Leimer-G/GamePad_BLE_Esp32/Schematic_GamePad_BLE.pdf

## SSD1306

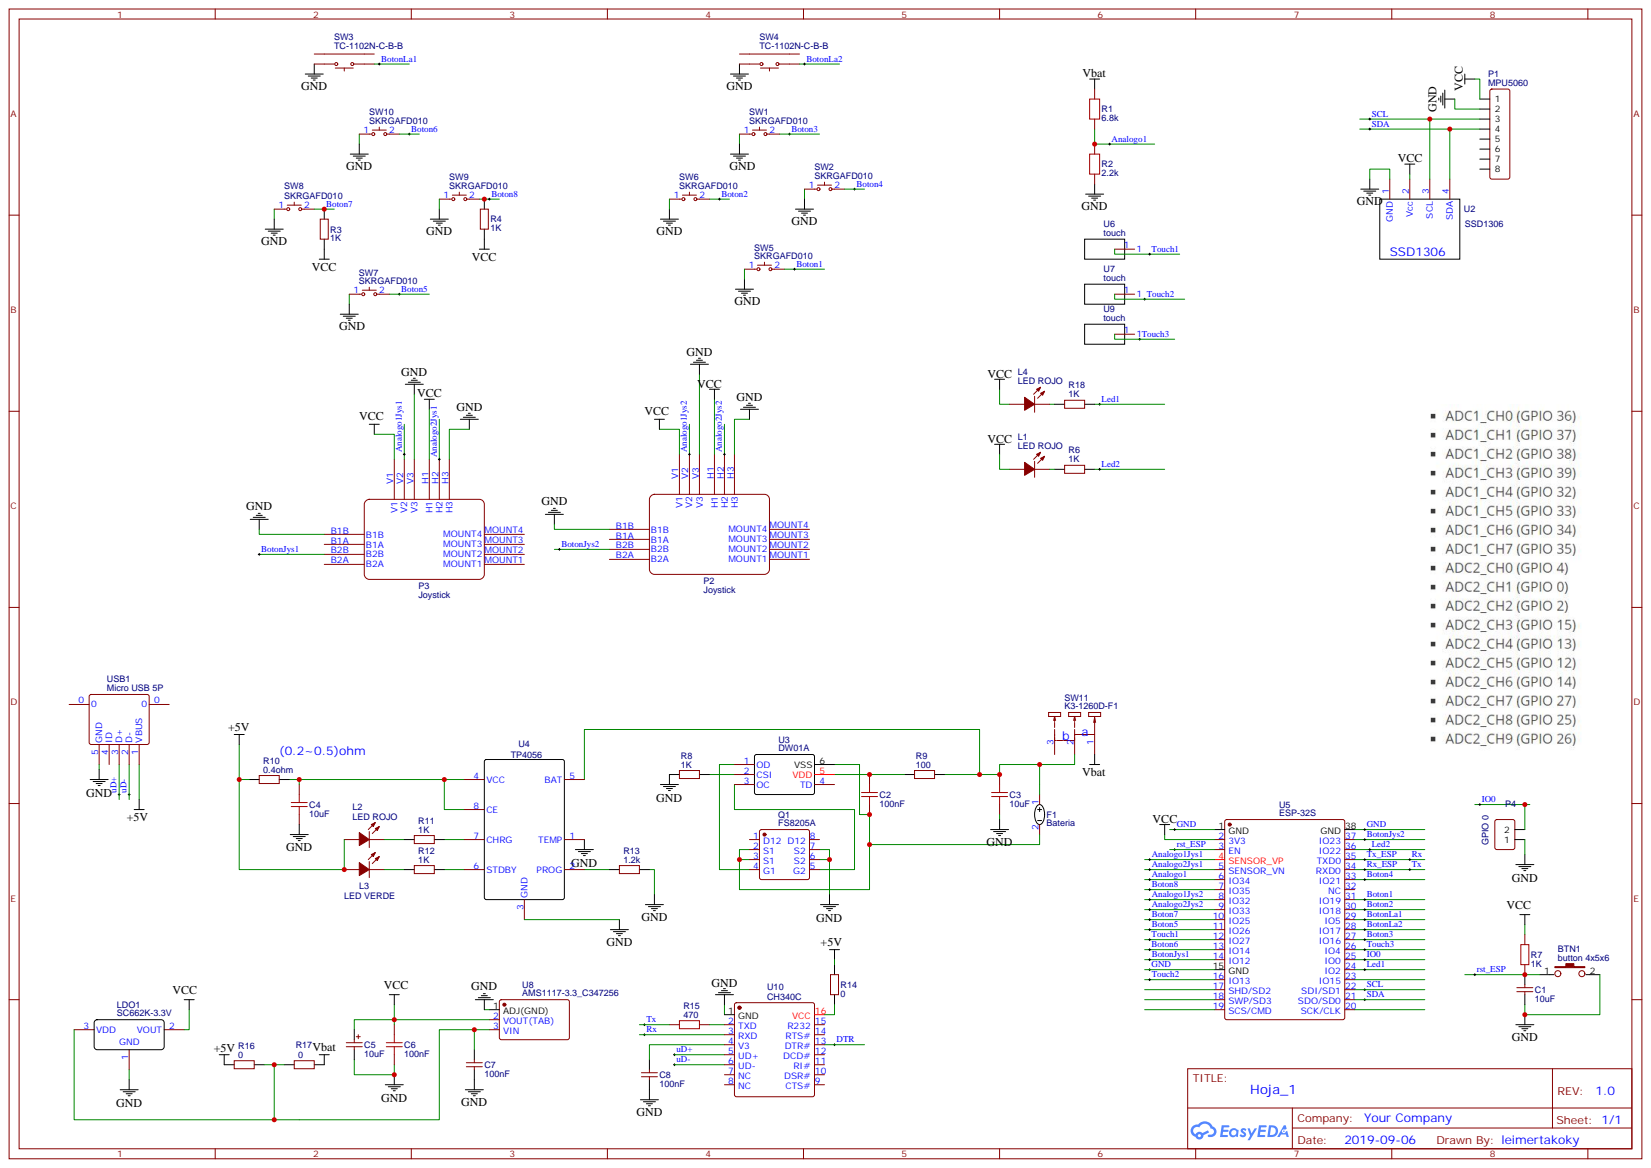
[picture p1: page 1]

DSR# 10 RI# 11 DCD# 12 DTR# 13 RTS# 14 R232 15 VCC 16
