Leimer-G/GamePad_BLE_Esp32/Codigo/GamePad_BLE/pines.h

// GATILLOS BUTTONS
#define LT 17 //BLA2
#define RT 5 //BLA1
#define LT2 27 //T1
#define RT2 4 //T3

// LEFT-JOYSTICK
#define LH 33   //A2J2
#define LV 32 //A2J1
#define LS 23

// RIGHT-JOYSTICK
#define RH 39 //A1J2 Sensor_VN  
#define RV 36 //A1J1 Sensor_VP 
#define RS 12

// D-PAD
#define L_Up 14   //B6
#define L_Down 26 // B5
#define L_Right 35 //res /B8
#define L_Left 25  //res B7

#define R_Up 16 //B3
#define R_Down 19 //B1
#define R_Right 21 //B4
#define R_Left 18 //B2

// BATTERY VOLTAGE
#define ADC 34
//LED
#define Led1 2
#define Led2 22
//Touch 2
#define Touch2 13
